dan-barham/fyxis/enclosure/preview_rear.png

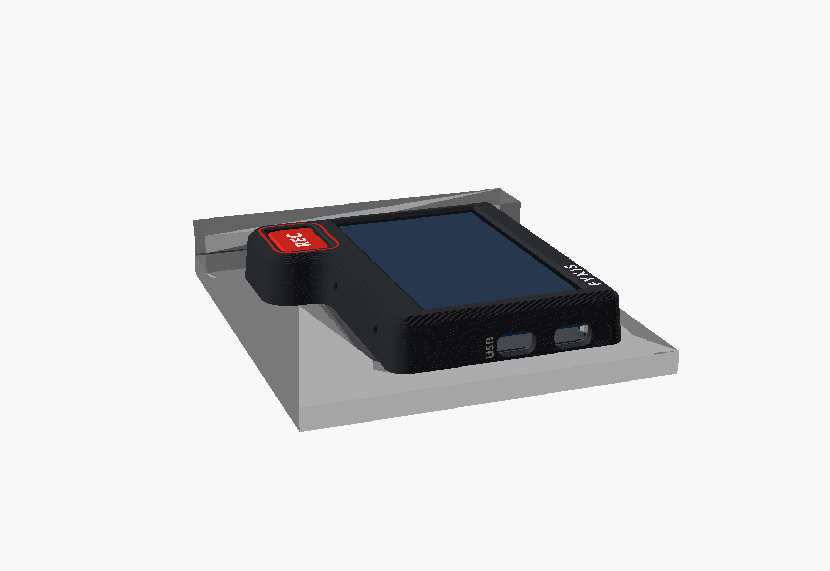
enclosure/preview_rear.png
