dan-barham/fyxis/enclosure/preview_section.png

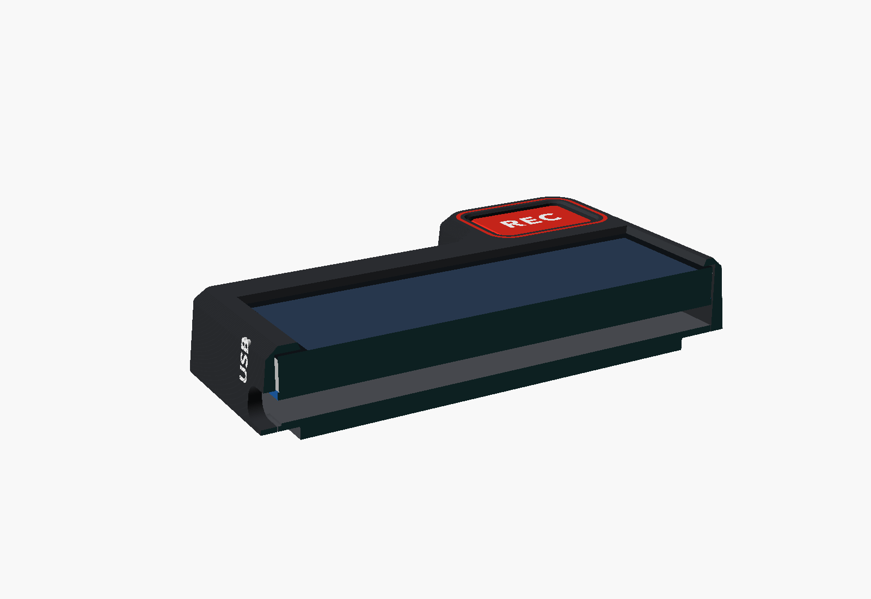
enclosure/preview_section.png
