dan-barham/fyxis/media/fyxis-angle-rec.jpg

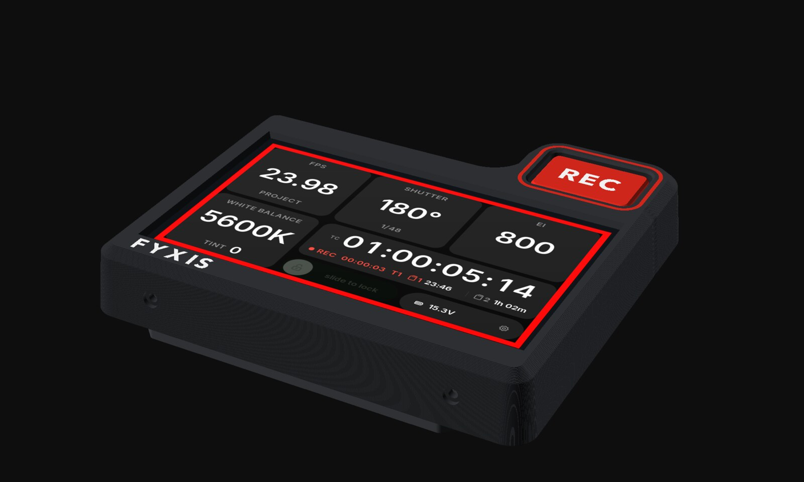
media/fyxis-angle-rec.jpg
