dan-barham/fyxis/media/screen-takes.png

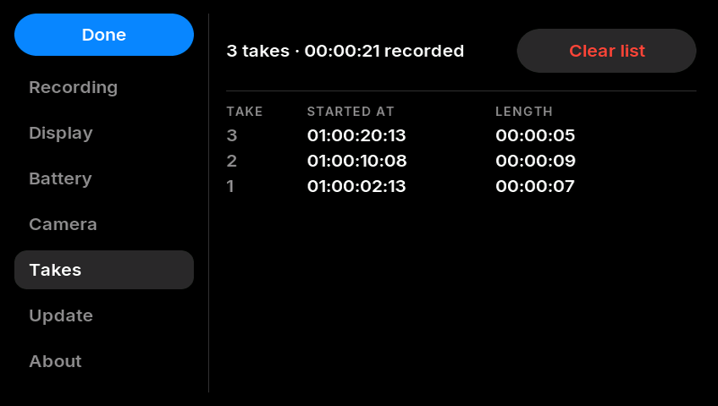
media/screen-takes.png
