dan-barham/fyxis/media/screen-update.png

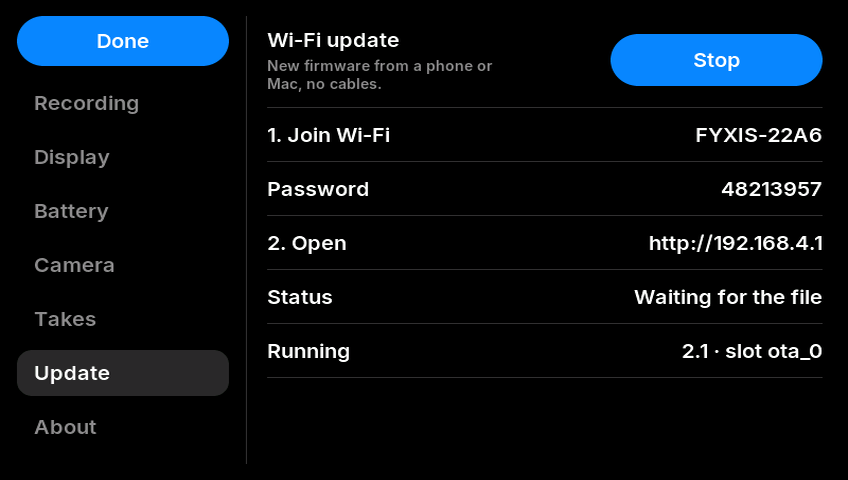
media/screen-update.png
