dan-barham/fyxis/enclosure/stl/fyxis_keycap.3mf

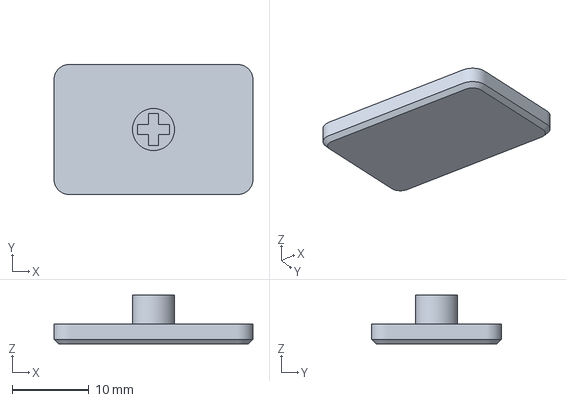
[picture p15: CAD file, 2026-11-09]
enclosure/stl/fyxis_keycap.3mf
26.0 x 17.0 x 6.40 mm
