dan-barham/fyxis/enclosure/stl/fyxis_tray.stl

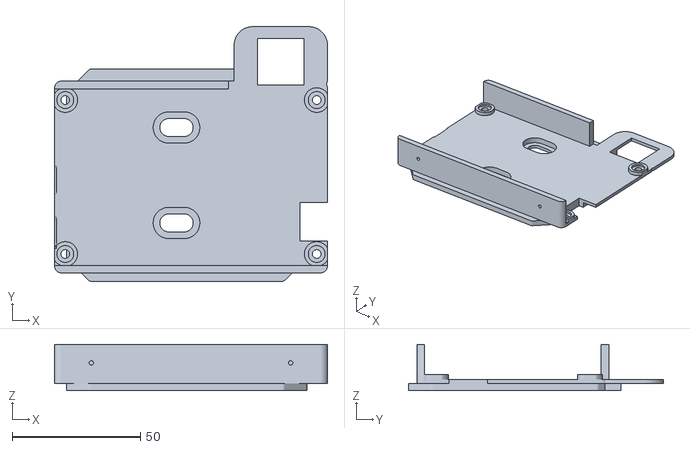
[picture p16: CAD file, 2026-11-09]
enclosure/stl/fyxis_tray.stl
106.4 x 99.2 x 18.0
