dan-barham/fyxis/enclosure/stl/fyxis_cap.3mf

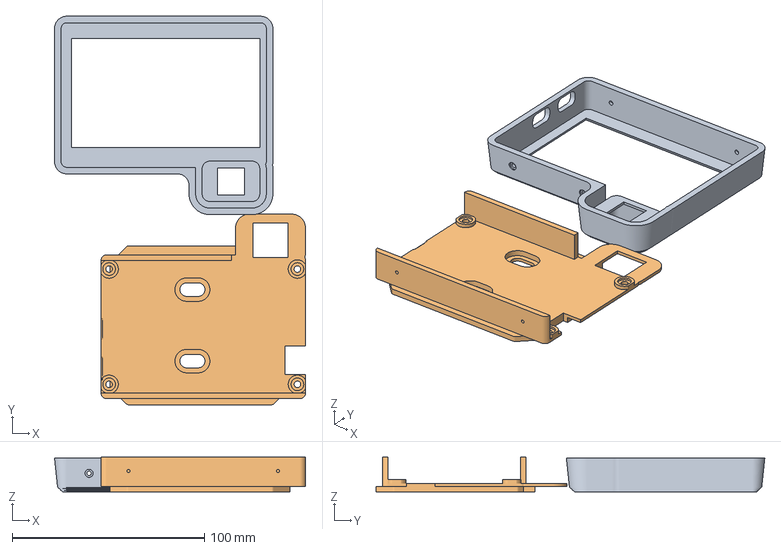
[picture p17: CAD file, 2026-11-09]
enclosure/stl/fyxis_cap.3mf
130.6 x 202.3 x 18.0 mm
fyxis_cap
fyxis_tray.stl
