dan-barham/fyxis/firmware/components/waveshare_rgb_lcd_port.c

/*
 * SPDX-FileCopyrightText: 2022 Espressif Systems (Shanghai) CO LTD
 *
 * SPDX-License-Identifier: CC0-1.0
 */

#include "waveshare_rgb_lcd_port.h"

static const char *TAG = "example";

esp_err_t waveshare_i2c_init(void)
{
    static bool i2c_initialized = false;
    const int i2c_master_port = I2C_MASTER_NUM;

    if (i2c_initialized) {
        return ESP_OK;
    }

    i2c_config_t i2c_conf = {
        .mode = I2C_MODE_MASTER,
        .sda_io_num = I2C_MASTER_SDA_IO,
        .scl_io_num = I2C_MASTER_SCL_IO,
        .sda_pullup_en = GPIO_PULLUP_ENABLE,
        .scl_pullup_en = GPIO_PULLUP_ENABLE,
        .master.clk_speed = I2C_MASTER_FREQ_HZ,
    };

    ESP_RETURN_ON_ERROR(i2c_param_config(i2c_master_port, &i2c_conf), TAG, "Configure I2C failed");
    ESP_RETURN_ON_ERROR(i2c_driver_install(i2c_master_port, i2c_conf.mode, 0, 0, 0), TAG, "Install I2C failed");

    i2c_initialized = true;
    return ESP_OK;
}

#if CONFIG_EXAMPLE_LCD_TOUCH_CONTROLLER_GT911
static void gpio_init(void)
{
    gpio_config_t io_conf = {
        .intr_type = GPIO_INTR_DISABLE,
        .mode = GPIO_MODE_OUTPUT,
        .pin_bit_mask = GPIO_INPUT_PIN_SEL,
    };
    gpio_config(&io_conf);
}

static void waveshare_esp32_s3_touch_reset(void)
{
    uint8_t write_buf = 0x01;
    i2c_master_write_to_device(I2C_MASTER_NUM, 0x24, &write_buf, 1, I2C_MASTER_TIMEOUT_MS / portTICK_PERIOD_MS);

    write_buf = 0x2C;
    i2c_master_write_to_device(I2C_MASTER_NUM, 0x38, &write_buf, 1, I2C_MASTER_TIMEOUT_MS / portTICK_PERIOD_MS);
    esp_rom_delay_us(100 * 1000);
    gpio_set_level(GPIO_INPUT_IO_4, 0);
    esp_rom_delay_us(100 * 1000);
    write_buf = 0x2E;
    i2c_master_write_to_device(I2C_MASTER_NUM, 0x38, &write_buf, 1, I2C_MASTER_TIMEOUT_MS / portTICK_PERIOD_MS);
    esp_rom_delay_us(200 * 1000);
}
#endif

esp_err_t waveshare_esp32_s3_rgb_lcd_init(
    uint8_t frame_buffer_count, esp_lcd_panel_handle_t *panel_handle, esp_lcd_touch_handle_t *touch_handle
)
{
    ESP_RETURN_ON_FALSE((panel_handle != NULL) && (touch_handle != NULL), ESP_ERR_INVALID_ARG, TAG, "Invalid arg");

    *panel_handle = NULL;
    *touch_handle = NULL;

    ESP_LOGI(TAG, "Install RGB LCD panel driver");
    esp_lcd_rgb_panel_config_t panel_config = {
        .clk_src = LCD_CLK_SRC_DEFAULT,
        .timings = {
            .pclk_hz = EXAMPLE_LCD_PIXEL_CLOCK_HZ,
            .h_res = EXAMPLE_LCD_H_RES,
            .v_res = EXAMPLE_LCD_V_RES,
#if ESP_PANEL_USE_1024_600_LCD
            .hsync_back_porch = 145,
            .hsync_front_porch = 170,
            .hsync_pulse_width = 30,
            .vsync_back_porch = 23,
            .vsync_front_porch = 12,
            .vsync_pulse_width = 2,
#else
            .hsync_pulse_width = 4,
            .hsync_back_porch = 8,
            .hsync_front_porch = 8,
            .vsync_pulse_width = 4,
            .vsync_back_porch = 8,
            .vsync_front_porch = 8,
#endif
            .flags = {
                .pclk_active_neg = 1,
            },
        },
        .data_width = EXAMPLE_RGB_DATA_WIDTH,
        .bits_per_pixel = EXAMPLE_RGB_BIT_PER_PIXEL,
        .num_fbs = frame_buffer_count,
        .bounce_buffer_size_px = EXAMPLE_RGB_BOUNCE_BUFFER_SIZE,
        .sram_trans_align = 4,
        .psram_trans_align = 64,
        .hsync_gpio_num = EXAMPLE_LCD_IO_RGB_HSYNC,
        .vsync_gpio_num = EXAMPLE_LCD_IO_RGB_VSYNC,
        .de_gpio_num = EXAMPLE_LCD_IO_RGB_DE,
        .pclk_gpio_num = EXAMPLE_LCD_IO_RGB_PCLK,
        .disp_gpio_num = EXAMPLE_LCD_IO_RGB_DISP,
        .data_gpio_nums = {
            EXAMPLE_LCD_IO_RGB_DATA0,
            EXAMPLE_LCD_IO_RGB_DATA1,
            EXAMPLE_LCD_IO_RGB_DATA2,
            EXAMPLE_LCD_IO_RGB_DATA3,
            EXAMPLE_LCD_IO_RGB_DATA4,
            EXAMPLE_LCD_IO_RGB_DATA5,
            EXAMPLE_LCD_IO_RGB_DATA6,
            EXAMPLE_LCD_IO_RGB_DATA7,
            EXAMPLE_LCD_IO_RGB_DATA8,
            EXAMPLE_LCD_IO_RGB_DATA9,
            EXAMPLE_LCD_IO_RGB_DATA10,
            EXAMPLE_LCD_IO_RGB_DATA11,
            EXAMPLE_LCD_IO_RGB_DATA12,
            EXAMPLE_LCD_IO_RGB_DATA13,
            EXAMPLE_LCD_IO_RGB_DATA14,
            EXAMPLE_LCD_IO_RGB_DATA15,
        },
        .flags = {
            .fb_in_psram = 1,
        },
    };

    ESP_RETURN_ON_ERROR(esp_lcd_new_rgb_panel(&panel_config, panel_handle), TAG, "Create RGB panel failed");

    ESP_LOGI(TAG, "Initialize RGB LCD panel");
    ESP_RETURN_ON_ERROR(esp_lcd_panel_init(*panel_handle), TAG, "Initialize RGB panel failed");

#if CONFIG_EXAMPLE_LCD_TOUCH_CONTROLLER_GT911
    ESP_LOGI(TAG, "Initialize I2C bus");
    ESP_RETURN_ON_ERROR(waveshare_i2c_init(), TAG, "Initialize I2C failed");
    ESP_LOGI(TAG, "Initialize GPIO");
    gpio_init();
    ESP_LOGI(TAG, "Reset touch controller");
    waveshare_esp32_s3_touch_reset();

    esp_lcd_panel_io_handle_t tp_io_handle = NULL;
    esp_lcd_panel_io_i2c_config_t tp_io_config = ESP_LCD_TOUCH_IO_I2C_GT911_CONFIG();
    tp_io_config.scl_speed_hz = 0;

    ESP_LOGI(TAG, "Initialize I2C panel IO");
    ESP_RETURN_ON_ERROR(
        esp_lcd_new_panel_io_i2c((esp_lcd_i2c_bus_handle_t)I2C_MASTER_NUM, &tp_io_config, &tp_io_handle),
        TAG, "Create touch IO failed"
    );

    ESP_LOGI(TAG, "Initialize touch controller GT911");
    const esp_lcd_touch_config_t tp_cfg = {
        .x_max = EXAMPLE_LCD_H_RES,
        .y_max = EXAMPLE_LCD_V_RES,
        .rst_gpio_num = EXAMPLE_PIN_NUM_TOUCH_RST,
        .int_gpio_num = EXAMPLE_PIN_NUM_TOUCH_INT,
        .levels = {
            .reset = 0,
            .interrupt = 0,
        },
        .flags = {
            .swap_xy = 0,
            .mirror_x = 0,                 // set from Settings in main.c
            .mirror_y = 0,
        },
    };
    ESP_RETURN_ON_ERROR(esp_lcd_touch_new_i2c_gt911(tp_io_handle, &tp_cfg, touch_handle), TAG, "Create GT911 failed");
#endif

    return ESP_OK;
}

esp_err_t waveshare_rgb_lcd_backlight_on(void)
{
    uint8_t write_buf = 0x01;
    ESP_RETURN_ON_ERROR(waveshare_i2c_init(), TAG, "Initialize I2C failed");
    ESP_RETURN_ON_ERROR(
        i2c_master_write_to_device(I2C_MASTER_NUM, 0x24, &write_buf, 1, I2C_MASTER_TIMEOUT_MS / portTICK_PERIOD_MS),
        TAG, "Configure CH422G failed"
    );

    write_buf = 0x1E;
    ESP_RETURN_ON_ERROR(
        i2c_master_write_to_device(I2C_MASTER_NUM, 0x38, &write_buf, 1, I2C_MASTER_TIMEOUT_MS / portTICK_PERIOD_MS),
        TAG, "Enable backlight failed"
    );
    return ESP_OK;
}
