dan-barham/fyxis/(commit log)

2026-11-09 FYXIS 2.1: side display and REC button for the Blackmagic PYXIS 12K
    Firmware (ESP-IDF + LVGL) for the Waveshare ESP32-S3-Touch-LCD-4.3, a Mac
    simulator, the printable enclosure, docs, and the project web page.
    [bigsix_enclosure.scad, fyxis_cap.3mf, fyxis_keycap.3mf, fyxis_tray.stl, partitions.csv]
2026-11-09 Sleep mode: screen off and slow Bluetooth scan with no camera
    After 1 min (Settings > Display > Sleep: 1 min, 5 min, Never) with no
    camera link, touch or REC press, the screen goes black, the backlight
    goes off, the panel's pixel clock drops to 4 MHz and Bluetooth scans
    60 ms in every 640 ms instead of continuously. The camera coming back,
    a touch or the REC key wakes it; the waking touch is swallowed. Never
    sleeps while connected, pairing or during a Wi-Fi update.
2026-11-10 Exposure lock, REC rolls from playback, playback test keys
    - Exposure lock (Settings > Camera): a frame-rate change, made on the
    board or the camera, also moves the shutter angle so the shutter speed
    stays the same. Past 360 deg the tile shows how many stops short it is.
    - REC clears the playback speed and loop flags, so it always rolls a clip,
    even from playback (checked on a PYXIS 12K).
    - Shared packets for playback (10.1 play / speed, 10.2 clip step) and
    test keys in the simulator's live mode; findings in docs/protocol.md.
    [bigsix.c, camera.h, camproto.c, camproto.h, settings.c, settings.h]
2026-11-10 Playback screen: play, pause, 2x, reverse, clip steps from the board
    Tap the card slots under the timecode to put the camera into playback
    and open a playback screen (the clip's timecode, previous / next clip,
    reverse, play / pause, 2x, Live view). It also opens when the camera
    plays back by itself and closes when it leaves playback; REC rolls a new
    clip from it. Locked editing only nudges the lock. Exposure lock ignores
    what the camera reports during playback. Icons are drawn shapes.
    [bigsix.c, camera.c, camera.h]
2026-11-10 Playback: fix next clip, add shuttle, IN / OUT and loop
    - Next clip: 10.2 takes one value (0 previous, 1 next). Two were sent,
    so both buttons meant previous and next did nothing.
    - Shuttle strip: drag for -32x to 32x (all tested on the PYXIS), let go
    to pause. Replaces the separate reverse and 2x buttons.
    - IN / OUT marks and LOOP, done on the board from the clip timecode: the
    PYXIS ignores the loop flags and has no seek over Bluetooth, so at OUT
    (or the end of the card) the board shuttles back at 32x to IN (or the
    start) and plays again.
    - Simulator: demo playback model (two clips, speeds, clip steps), and
    live test keys for speeds and loop flags. Protocol notes corrected.
    Co-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
    [bigsix.c, camera.c, camproto.c, camproto.h]
2026-11-10 Simpler playback, Presets / Playback buttons on the main screen
    - Playback screen: four big buttons (previous, play / pause, next, loop)
    and a big Live view. IN / OUT and the shuttle strip are gone (IN / OUT
    from timecode wasn't reliable).
    - Loop: at the end of the card the board steps back clip by clip to the
    first one (until the timecode stops changing), then plays.
    - Main screen: Presets and Playback buttons bottom left, dimmed when they
    can't be used; tapping the timecode or the card slots no longer opens
    anything. The WB tile is as tall as the timecode tile: 5600K over
    "WB · TINT 0".
    - Screenshots and docs updated.
    [bigsix.c]
2026-11-10 Playback: loop clip / all, Tabler icons, Exit playback
    - Loop cycles Off / Clip / All. The PYXIS stops at the end of each clip
    unless the play-all flag is set, and never loops itself, so:
    Clip goes back to the start of the same clip (previous, then next
    unless the timecode shows it's already there); All sends play-all and
    steps back to the first clip at the end of the card.
    - Main screen: bookmarks and play icons instead of "Presets" and
    "Playback". Playback screen: Tabler skip / play / pause / repeat
    icons. New font_icons_56 and two glyphs added to font_icons_28, from
    Tabler Icons 3.31.0 (the version the other icon fonts use).
    - "Live view" renamed "Exit playback" (the board s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
    [bigsix.c, camera.c, camera.h]
2026-11-10 Playback: loop from the timecode jump into the next clip
    The PYXIS plays on through every clip whatever the loop / play-all
    flags say, so Loop Clip on any clip but the last ran on into the next.
    The board now sees the next clip start as a jump in the timecode and
    steps back with previous; at the end of the card it sends previous and
    next together. Each step is checked against the clip's start. Loop All
    steps back by the number of clip changes seen. The demo camera now
    plays through all three of its clips like the real one.
2026-11-10 Remove playback; Settings gets its own button next to Presets
    Looping over Bluetooth never worked reliably, so the playback screen,
    its button, the playback commands and the simulator's playback model
    and test keys are gone. REC still rolls a clip if the camera is in its
    own playback.
    Settings opens from a gear button the same size as the Presets button,
    bottom left; the battery strip just shows the battery, centred.
2026-11-10 Tap the battery strip for a full-screen battery graph
    The reading, the time left, and the last 2 hours against a volt scale,
    with the low and critical levels marked. Tap anywhere or Done to close;
    not while recording. The Settings › Battery graph shares the code.
2026-11-11 Editors: quick picks, bigger buttons, frame rates limited by resolution
    - Every editor gets a row of quick-pick chips: shutter angles and speeds,
    EIs and white balances as well as frame rates.
    - Frame rates above the camera's maximum at the current resolution are
    greyed out, and - / + and Custom stop there (table from Blackmagic's
    PYXIS 12K specs; unknown resolutions allow up to 120). Shutter speeds
    slower than one frame are greyed out too.
    - Done and Custom are bigger (240 x 76), and each heading has more room
    above its value.
    - A few hidden extras.
